Klaus-00/LiftUp-Thrust-Test-Stand/Test_Output/Image/13x10_Prop_Thrust&Torque_x_PWM.png

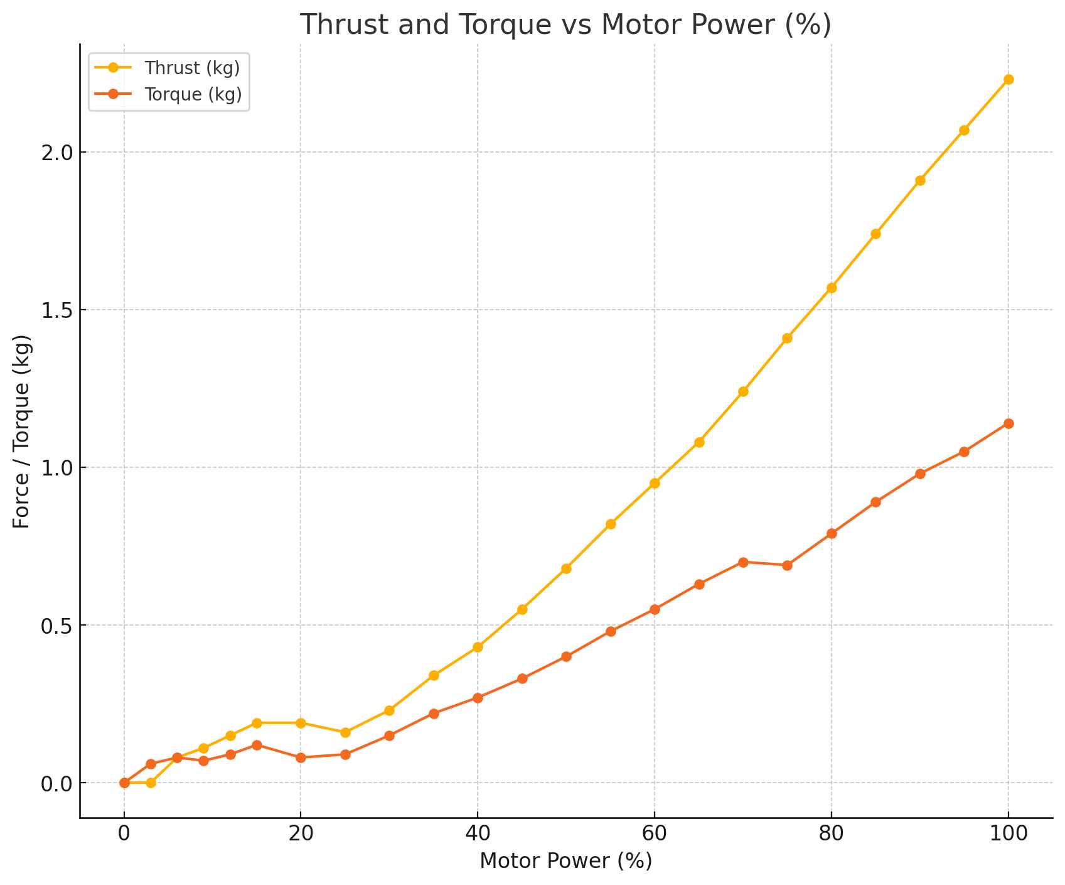
Test_Output/Image/13x10_Prop_Thrust&Torque_x_PWM.png
